mgit-at/raspiECC/(threads)

Thread 1 (2022-12-05):

Getting raspiECC

psvz, 2022-12-05:
I couldn't find where to get raspiECC board these days... any idea?

gebi, 2022-12-05:
hi @psvz , the fastes way would probably just uploading the gerber files yourself to something like https://jlcpcb.com/ and solder raspiECC yourself :).

(sry we have never sold finished kits of our raspiECC boards on the internet, just gave out a few at linuxdays, where did you find them in the past?)

Closed 2022-12-05.
