mgit-at/raspiECC/(commit log)

2019-04-04 initial version of the board
    [raspiECCv1.kicad_pcb, raspiECCv1.sch]
2019-04-04 replace Pin Header with Socket Header and make 3D rendering
    [raspiECCv1.kicad_pcb, raspiECCv1.sch]
2019-04-04 minor cleanup
    [raspiECCv1.kicad_pcb, raspiECCv1.sch]
2019-04-05 make pcb a little nicer
    [raspiECCv1.kicad_pcb]
2019-04-05 added mgit logo
    [raspiECCv1.kicad_pcb]
2019-04-05 make pcb narrow to keep out of mounting holes
    [raspiECCv1.kicad_pcb]
2019-04-05 added gerber files
    [raspiECCv1-B_Cu.gbr, raspiECCv1-B_Mask.gbr, raspiECCv1-B_Paste.gbr, raspiECCv1-B_SilkS.gbr, raspiECCv1-Edge_Cuts.gbr, raspiECCv1-F_Cu.gbr, raspiECCv1-F_Mask.gbr, raspiECCv1-F_Paste.gbr]
2019-04-05 add gerber job file
    [raspiECCv1-B_Cu.gbr, raspiECCv1-B_Mask.gbr, raspiECCv1-B_Paste.gbr, raspiECCv1-B_SilkS.gbr, raspiECCv1-Edge_Cuts.gbr, raspiECCv1-F_Cu.gbr, raspiECCv1-F_Mask.gbr, raspiECCv1-F_Paste.gbr]
